eca-automs/MC-POL48MIAE-06/README.md

# MC-POL48MIAE-06
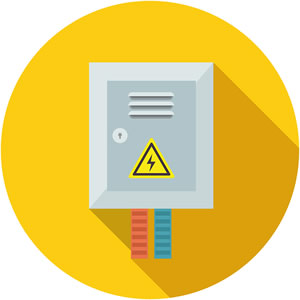
[picture p1: res/el_icon_4.jpg]
electric_panel_icon

## Schema per quadro elettrico per ascensore

### Scheda controllo
MCPX2015-SMD - PER16B-SMD

### Tipo impianto
Oleodinamico.

### Manovra
Prenotazione.

### Operatore porte
Automatico trifase, automatico elettronico.

### Avviamento / controllo motore
Diretto, stella-triangolo, soft-starter con SMS-Start.

### Potenza massima motore / taglie compatibili

#### Avviamento diretto
Taglia|Potenza
---|---
S40|14CV-230VAC/22CV-400VAC

#### Avviamento stella-triangolo
Taglia|Potenza
---|---
S70|24CV-230VAC/43CV-400VAC

#### Avviamento soft-starter
Taglia|Potenza
---|---
S60|17CV-230VAC/35CV-400VAC

### Allarme
12VDC, Legge 13.

### Emergenza
Totale con riapertura porte con inverter SMS MIAE.

### Emendamento A3
Nessuno.
