eca-automs/MC-POL48MIAE-06/dxf/7-MC-POL48MIAE-06.dxf

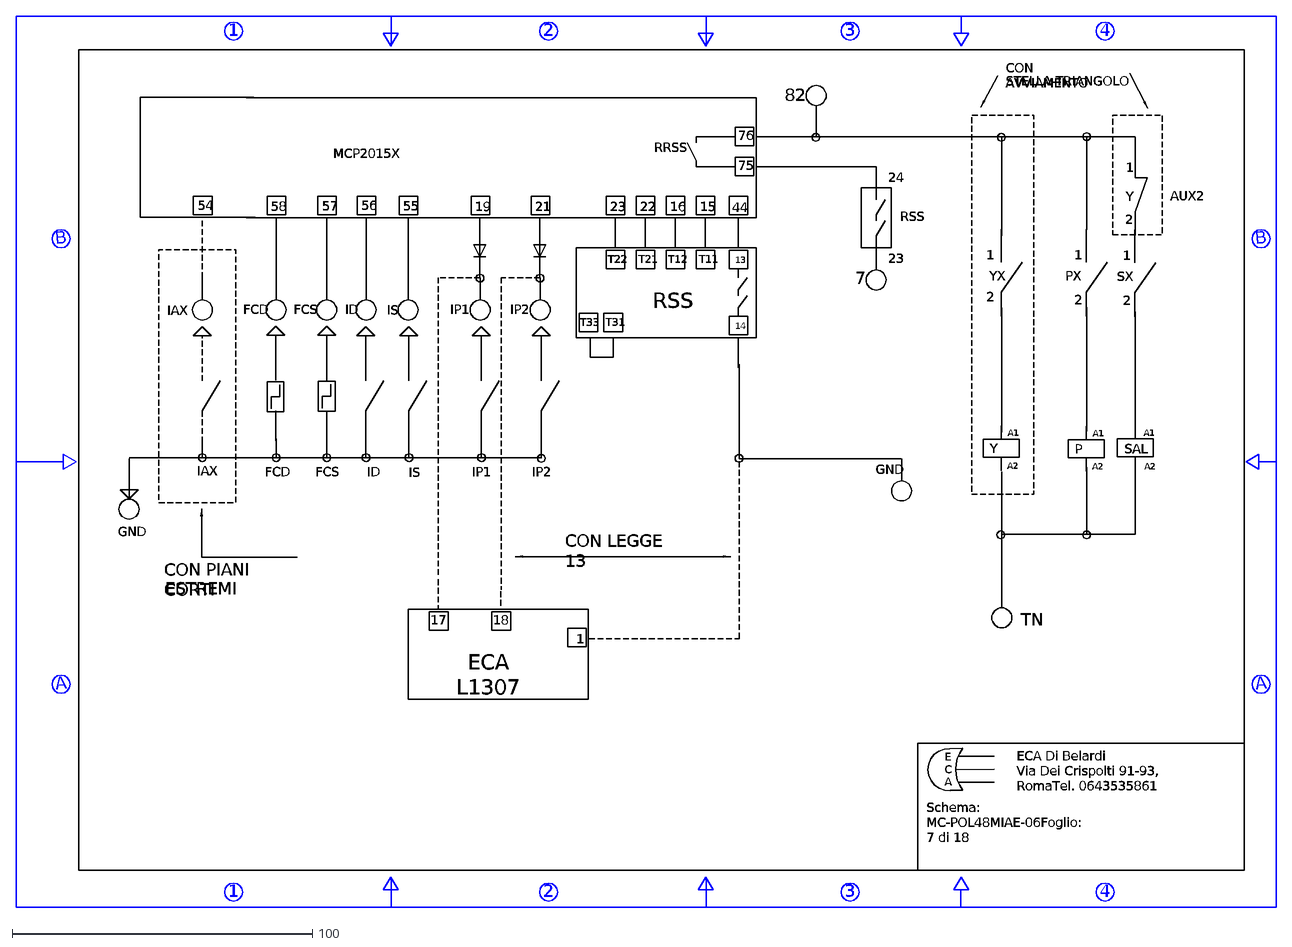
[picture p2: CAD file, 2018-07-23]
dxf/7-MC-POL48MIAE-06.dxf
A
B
1
2
3
4
E C A
ECA Di Belardi Via Dei Crispolti 91-93, Roma Tel. 0643535861
MCP2015X
58
T22
T21
T12
T11
23
22
16
15
13
14
44
FCD
76
75
RRSS
24
RSS
7
T31
19
21
IP1
IP2
57
FCS
ID
56
55
IS
17
ECA L1307
18
54
IAX
CON PIANI CORTI
ESTREMI
CON LEGGE 13
GND
A1
A2
SAL
YX
PX
SX
Y
P
TN
T33
STELLA-TRIANGOLO
CON AVVIAMENTO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
