eca-automs/MC-POL48MIAE-06/dxf/12-MC-POL48MIAE-06.dxf

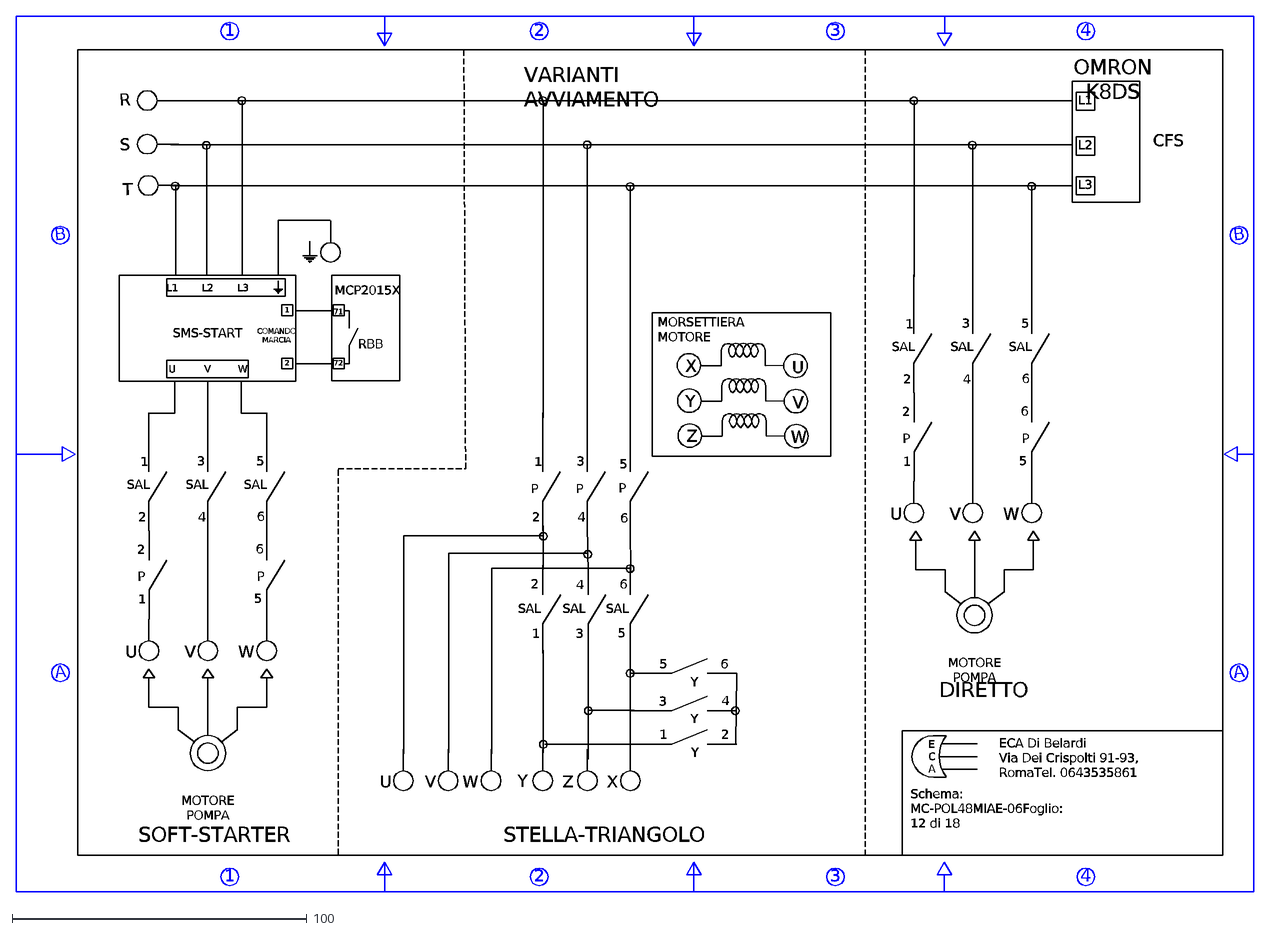
[picture p3: CAD file, 2018-07-23]
dxf/12-MC-POL48MIAE-06.dxf
A
B
1
2
3
4
E C A
ECA Di Belardi Via Dei Crispolti 91-93, Roma Tel. 0643535861
R
S
T
L2
L1
L3
OMRON K8DS
U
V
W
COMANDO MARCIA
71
72
SMS-START
MCP2015X
MOTORE POMPA
SAL
P
5
6
Y
X
Z
MORSETTIERA MOTORE
VARIANTI AVVIAMENTO
SOFT-STARTER
STELLA-TRIANGOLO
DIRETTO
RBB
CFS
Schema: MC-POL48MIAE-06 Foglio: 12 di 18
