eca-automs/MC-POL48MIAE-06/dxf/11-MC-POL48MIAE-06.dxf

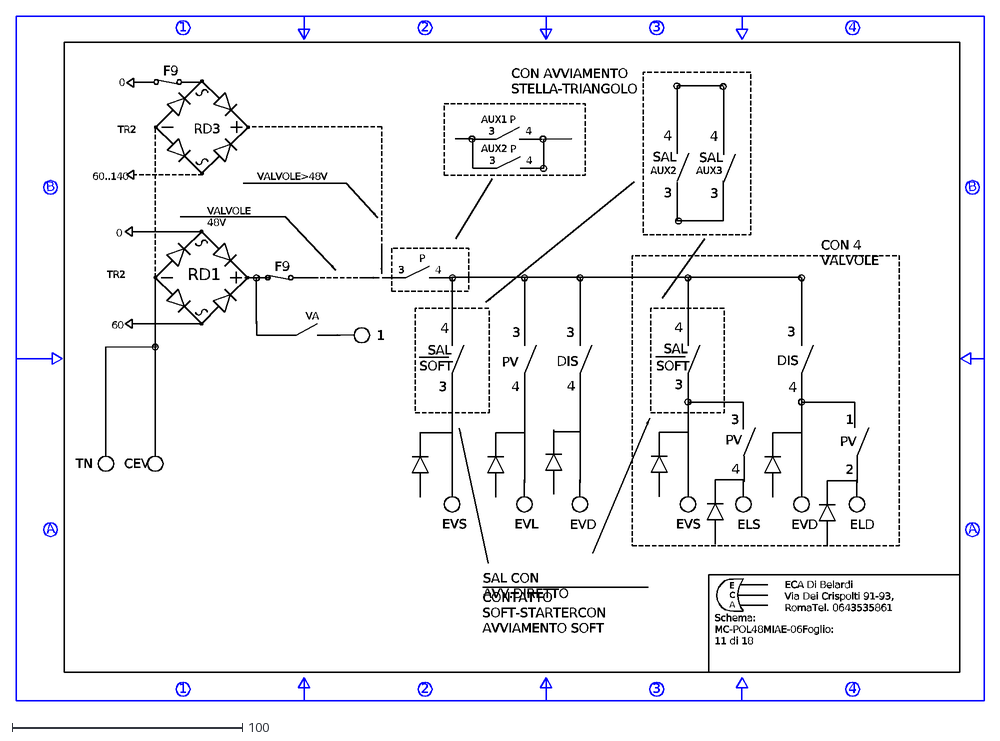
[picture p4: CAD file, 2018-07-23]
dxf/11-MC-POL48MIAE-06.dxf
A
B
1
2
3
4
E C A
ECA Di Belardi Via Dei Crispolti 91-93, Roma Tel. 0643535861
RD1
0
60
TR2
F9
P
VA
VALVOLE 48V
VALVOLE>48V
RD3
60..140
TN
CEV
EVL
ELS
ELD
DIS
EVS
EVD
PV
SAL
SOFT
CON 4 VALVOLE
SAL CON AVV.DIRETTO
CONTATTO SOFT-STARTER CON AVVIAMENTO SOFT
AUX1
AUX2
CON AVVIAMENTO STELLA-TRIANGOLO
Schema: MC-POL48MIAE-06 Foglio: 11 di 18
AUX3
