eca-automs/MC-POL48MIAE-06/dxf/2-MC-POL48MIAE-06.dxf

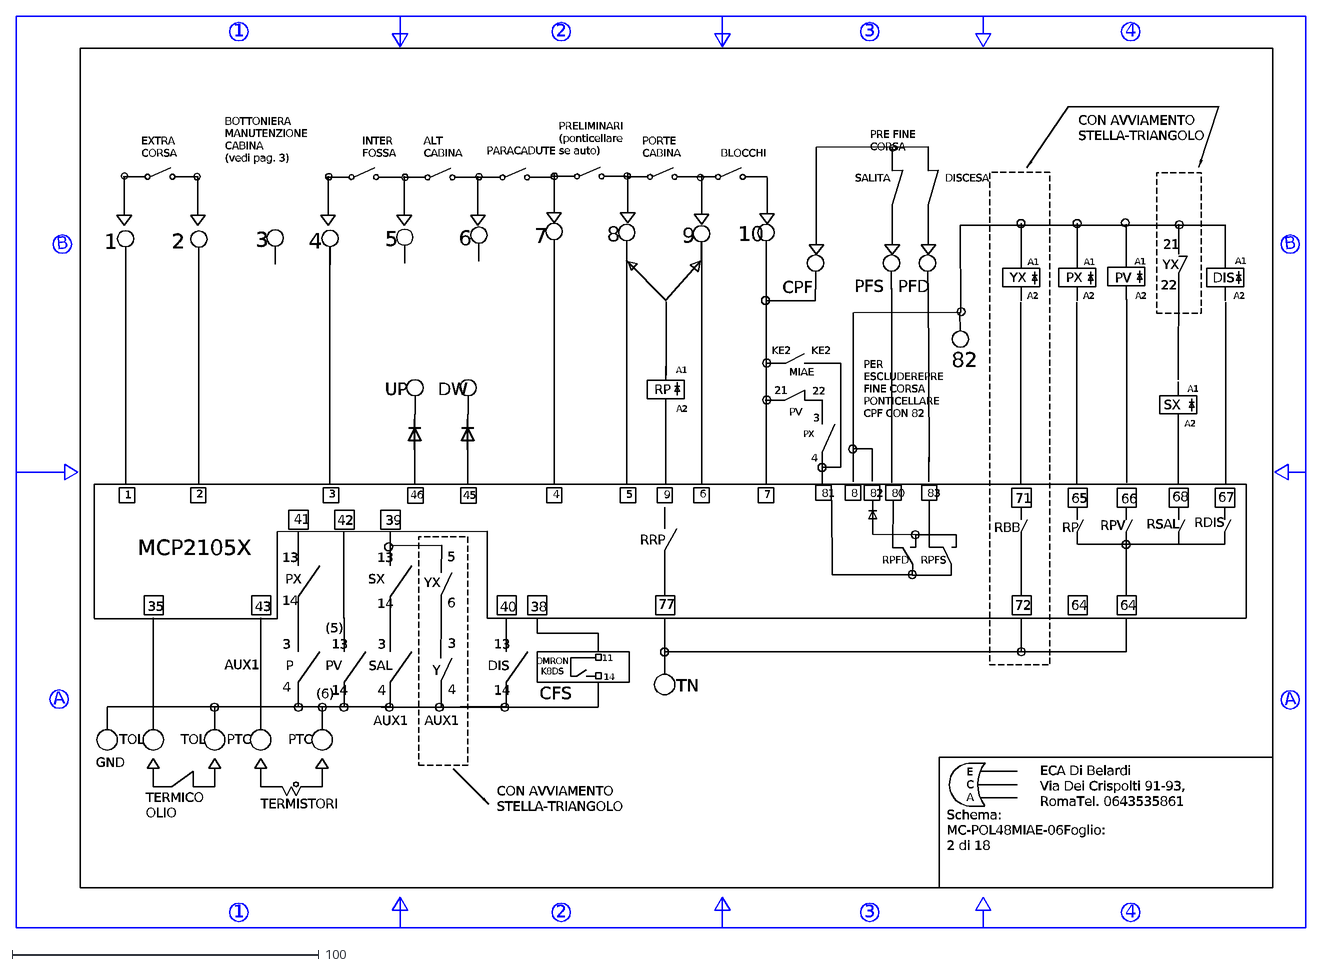
[picture p5: CAD file, 2018-07-23]
dxf/2-MC-POL48MIAE-06.dxf
E C A
ECA Di Belardi Via Dei Crispolti 91-93, Roma Tel. 0643535861
B
A
1
2
3
4
65
PV
DIS
64
RP
RPV
RSAL
RDIS
66
68
67
TOL
PTC
35
43
13
14
40
A1
A2
TERMICO OLIO
TERMISTORI
RBB
71
72
CON AVVIAMENTO STELLA-TRIANGOLO
5
6
9
7
8
EXTRA CORSA
INTER FOSSA
PRELIMINARI (ponticellare se auto)
ALT CABINA
PORTE CABINA
PARACADUTE
BLOCCHI
38
OMRON K8DS
11
CFS
RRP
77
TN
PRE FINE CORSA
SALITA
DISCESA
82
80
83
RPFD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
