eca-automs/MC-POL48MIAE-06/dxf/1-MC-POL48MIAE-06.dxf

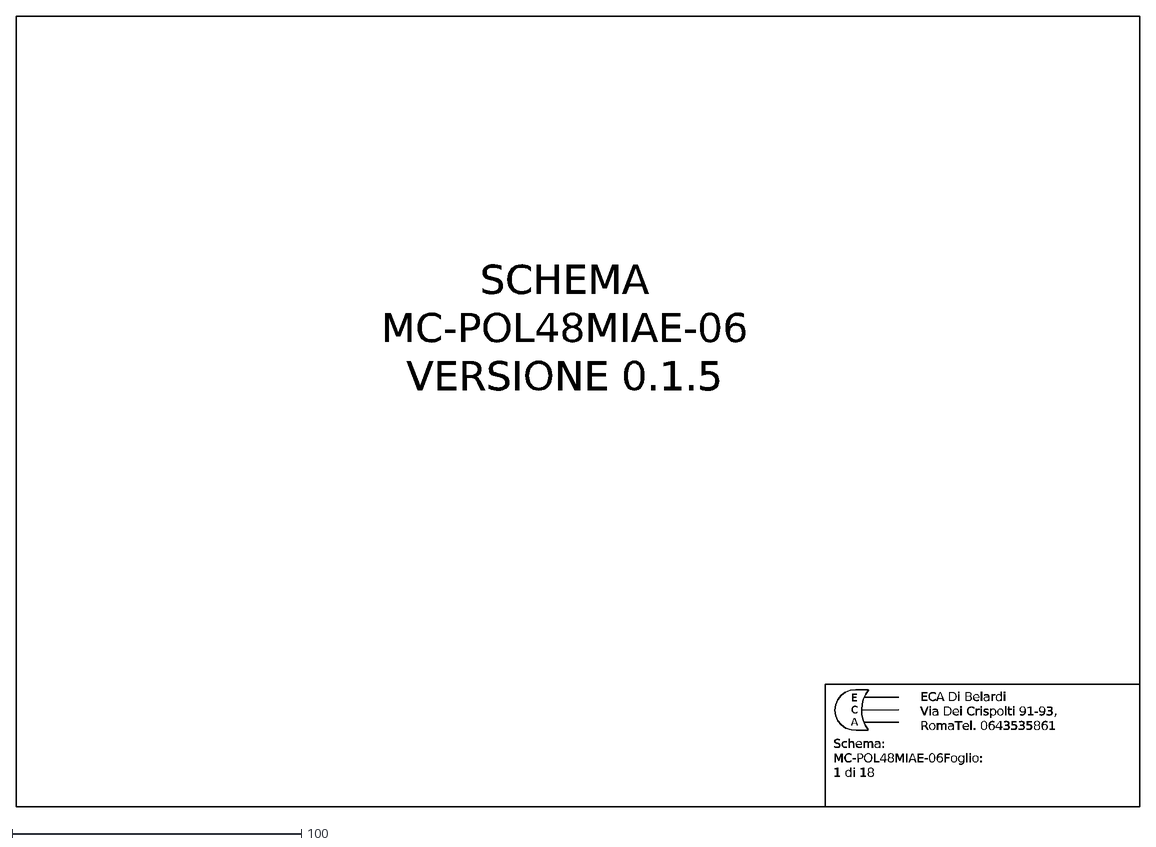
[picture p6: CAD file, 2018-07-23]
dxf/1-MC-POL48MIAE-06.dxf
E C A
ECA Di Belardi Via Dei Crispolti 91-93, Roma Tel. 0643535861
Schema: MC-POL48MIAE-06 Foglio: 1 di 18
SCHEMA MC-POL48MIAE-06 VERSIONE 0.1.5
