eca-automs/MC-POL48MIAE-06/dxf/10-MC-POL48MIAE-06.dxf

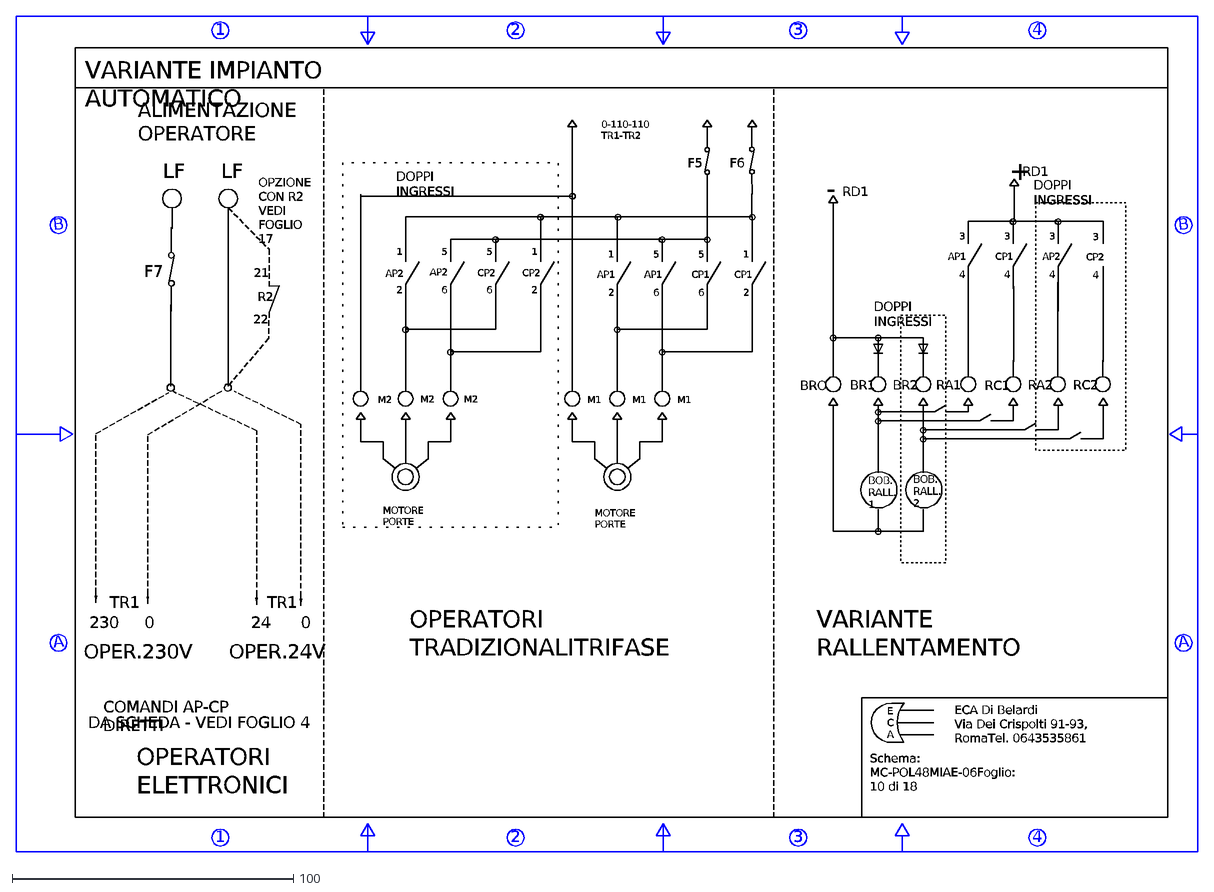
[picture p7: CAD file, 2018-05-28]
dxf/10-MC-POL48MIAE-06.dxf
A
B
1
2
3
4
E C A
ECA Di Belardi Via Dei Crispolti 91-93, Roma Tel. 0643535861
OPERATORI ELETTRONICI
230
0
24
TR1
LF
ALIMENTAZIONE OPERATORE
OPER.230V
OPER.24V
COMANDI AP-CP DIRETTI
VARIANTE IMPIANTO AUTOMATICO
F7
MOTORE PORTE
AP1
CP1
5
6
AP2
CP2
0-110-110 TR1-TR2
M1
M2
DOPPI INGRESSI
F5
F6
BRO
BR1
BR2
RA1
RC1
RA2
RC2
BOB. RALL. 1
BOB. RALL. 2
-
+
RD1
VARIANTE RALLENTAMENTO
OPERATORI TRADIZIONALI TRIFASE
DA SCHEDA - VEDI FOGLIO 4
R2
21
22
OPZIONE CON R2 VEDI FOGLIO 17
Schema: MC-POL48MIAE-06 Foglio: 10 di 18
