eca-automs/MC-POL48MIAE-06/dxf/18-MC-POL48MIAE-06.dxf

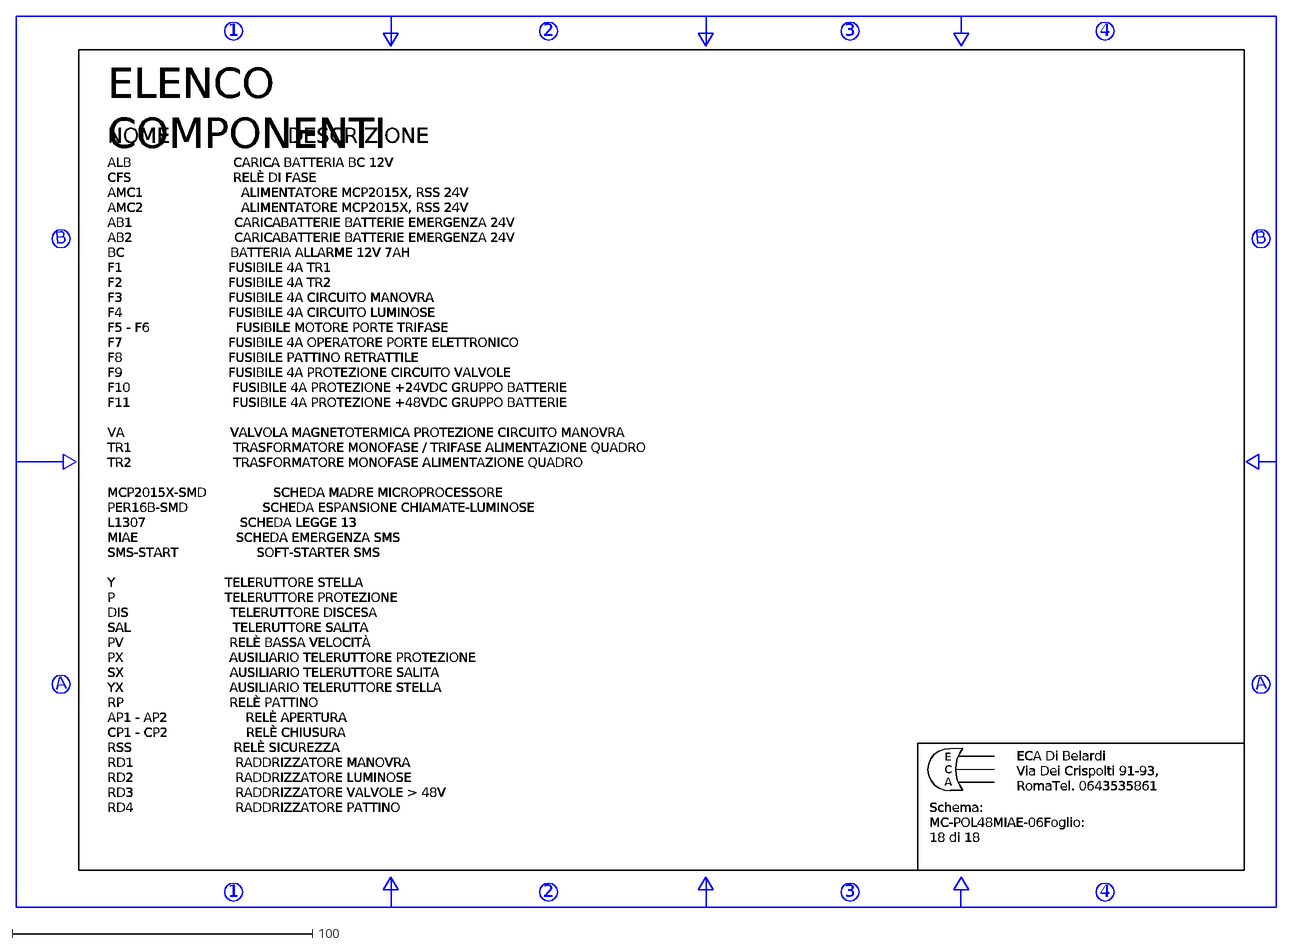
[picture p8: CAD file, 2018-05-28]
dxf/18-MC-POL48MIAE-06.dxf
A
B
1
2
3
4
E C A
ECA Di Belardi Via Dei Crispolti 91-93, Roma Tel. 0643535861
DESCRIZIONE
ELENCO COMPONENTI
NOME
ALB CARICA BATTERIA BC 12V CFS RELÈ DI FASE AMC1 ALIMENTATORE MCP2015X, RSS 24V AMC2 ALIMENTATORE MCP2015X, RSS 24V AB1 CARICABATTERIE BATTERIE EMERGENZA 24V AB
Schema: MC-POL48MIAE-06 Foglio: 18 di 18
