eca-automs/MC-POL48MIAE-06/dxf/8-MC-POL48MIAE-06.dxf

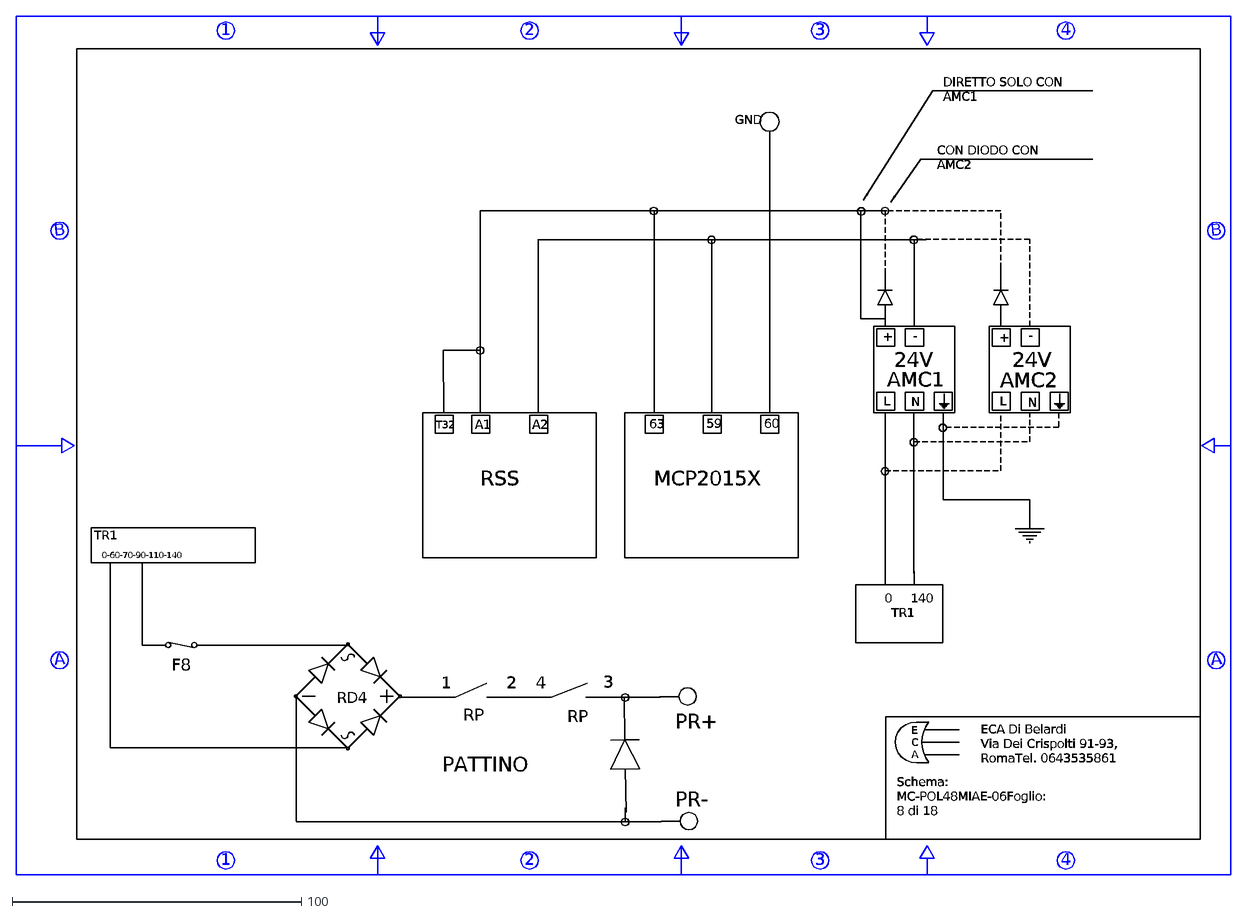
[picture p9: CAD file, 2018-05-28]
dxf/8-MC-POL48MIAE-06.dxf
A
B
1
2
3
4
E C A
MCP2015X
A1
A2
63
59
60
GND
+
-
L
N
ECA Di Belardi Via Dei Crispolti 91-93, Roma Tel. 0643535861
RSS
DIRETTO SOLO CON AMC1
CON DIODO CON AMC2
0
TR1
140
T32
24V
AMC2
AMC1
RP
PR+
PR-
PATTINO
F8
RD4
0-60-70-90-110-140
Schema: MC-POL48MIAE-06 Foglio: 8 di 18
