eca-automs/MC-POL48MIAE-06/dxf/3-MC-POL48MIAE-06.dxf

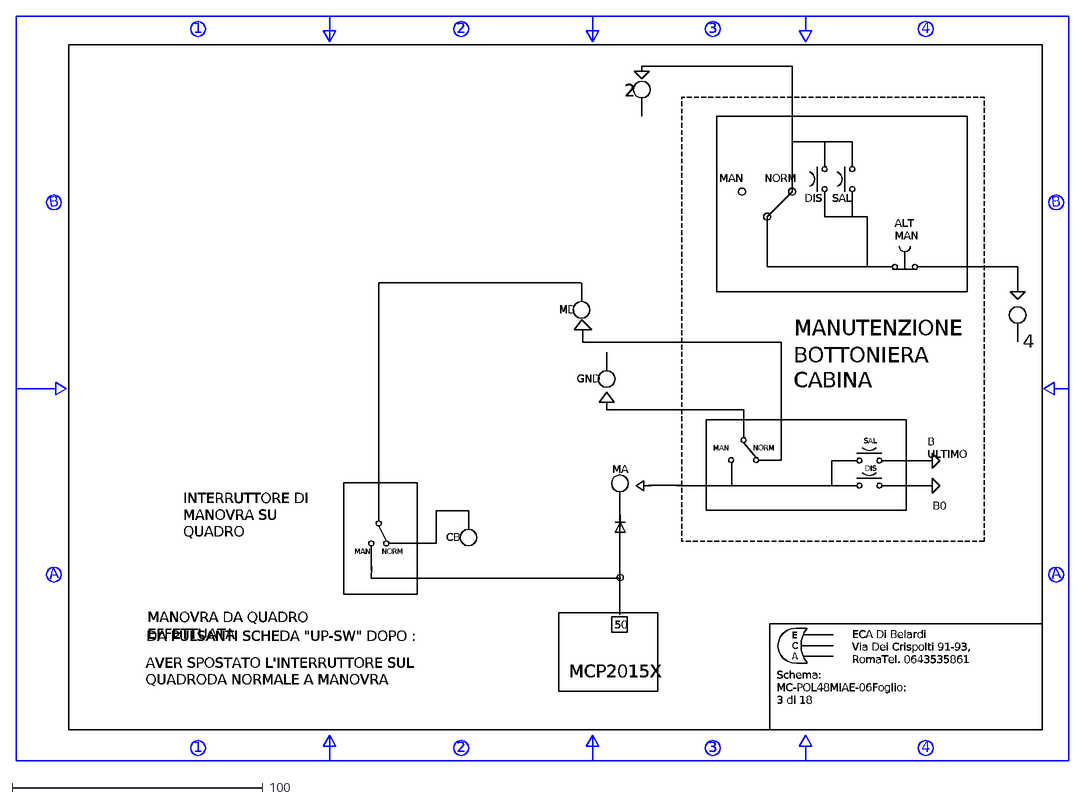
[picture p11: CAD file, 2018-05-28]
dxf/3-MC-POL48MIAE-06.dxf
A
B
1
2
3
4
E C A
ECA Di Belardi Via Dei Crispolti 91-93, Roma Tel. 0643535861
MAN
NORM
ALT MAN
DIS
SAL
MB
GND
MA
MCP2015X
50
MANOVRA DA QUADRO EFFETTUATA
DA PULSANTI SCHEDA "UP-SW" DOPO :
AVER SPOSTATO L'INTERRUTTORE SUL QUADRO DA NORMALE A MANOVRA
INTERRUTTORE DI MANOVRA SU QUADRO
BOTTONIERA CABINA
MANUTENZIONE
CB
B ULTIMO
B0
Schema: MC-POL48MIAE-06 Foglio: 3 di 18
