eca-automs/MC-POL48MIAE-06/dxf/13-MC-POL48MIAE-06.dxf

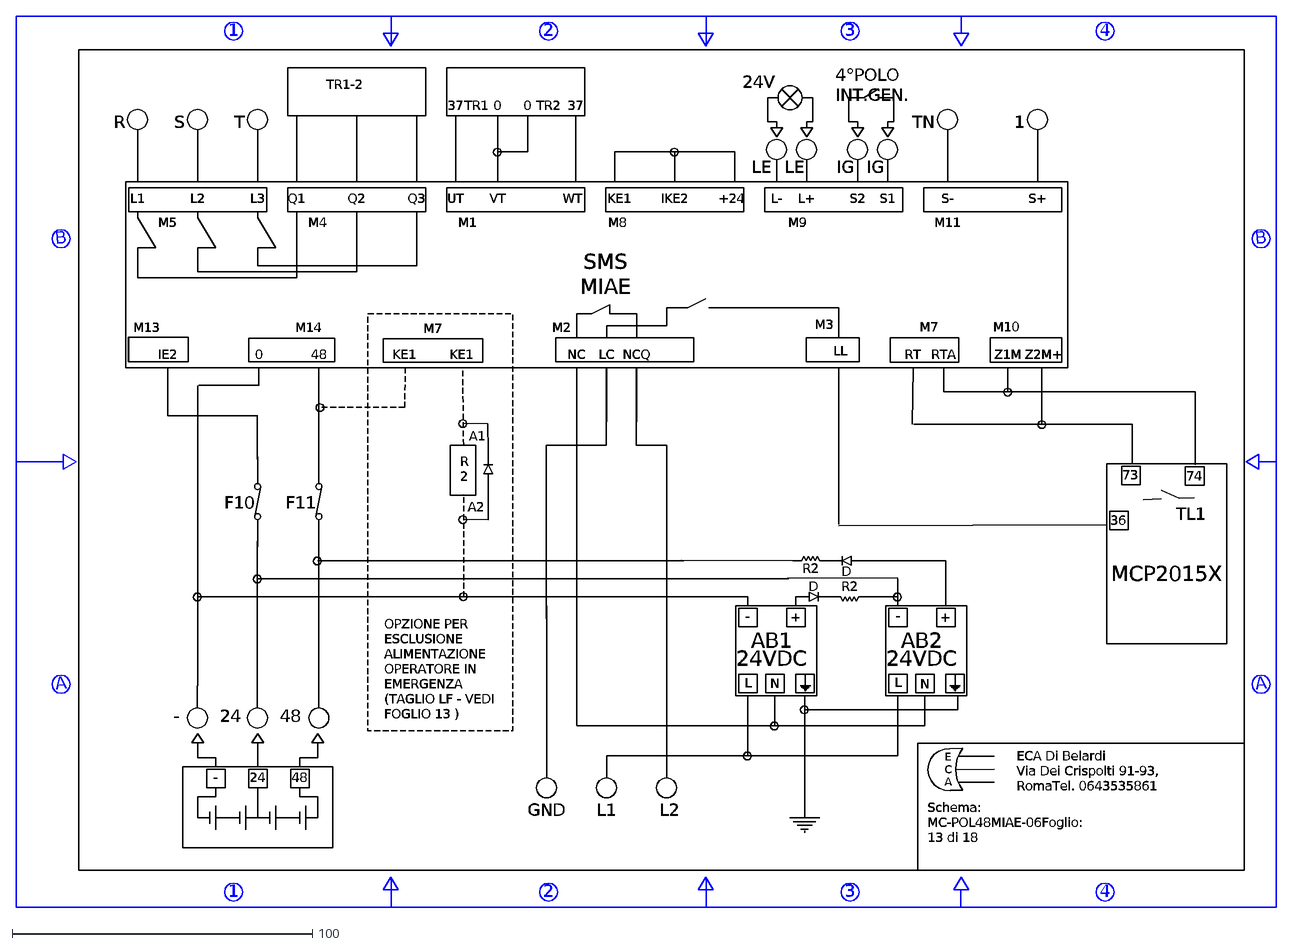
[picture p12: CAD file, 2018-05-28]
dxf/13-MC-POL48MIAE-06.dxf
A
B
1
2
3
4
E C A
M5
M4
M1
M8
M9
M11
M13
M14
L1
L2
L3
Q1
Q2
Q3
UT
VT
WT
37
0
TR1
TR2
TR1-2
IKE1
IKE2
+24
L-
L+
S2
S1
S-
S+
IE2
R
S
T
LE
IG
SMS MIAE
24
48
-
TN
ECA Di Belardi Via Dei Crispolti 91-93, Roma Tel. 0643535861
MCP2015X
36
73
74
24V
4°POLO INT.GEN.
F10
F11
TL1
Z2M+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
