eca-automs/MC-POL48MIAE-06/dxf/14-MC-POL48MIAE-06.dxf

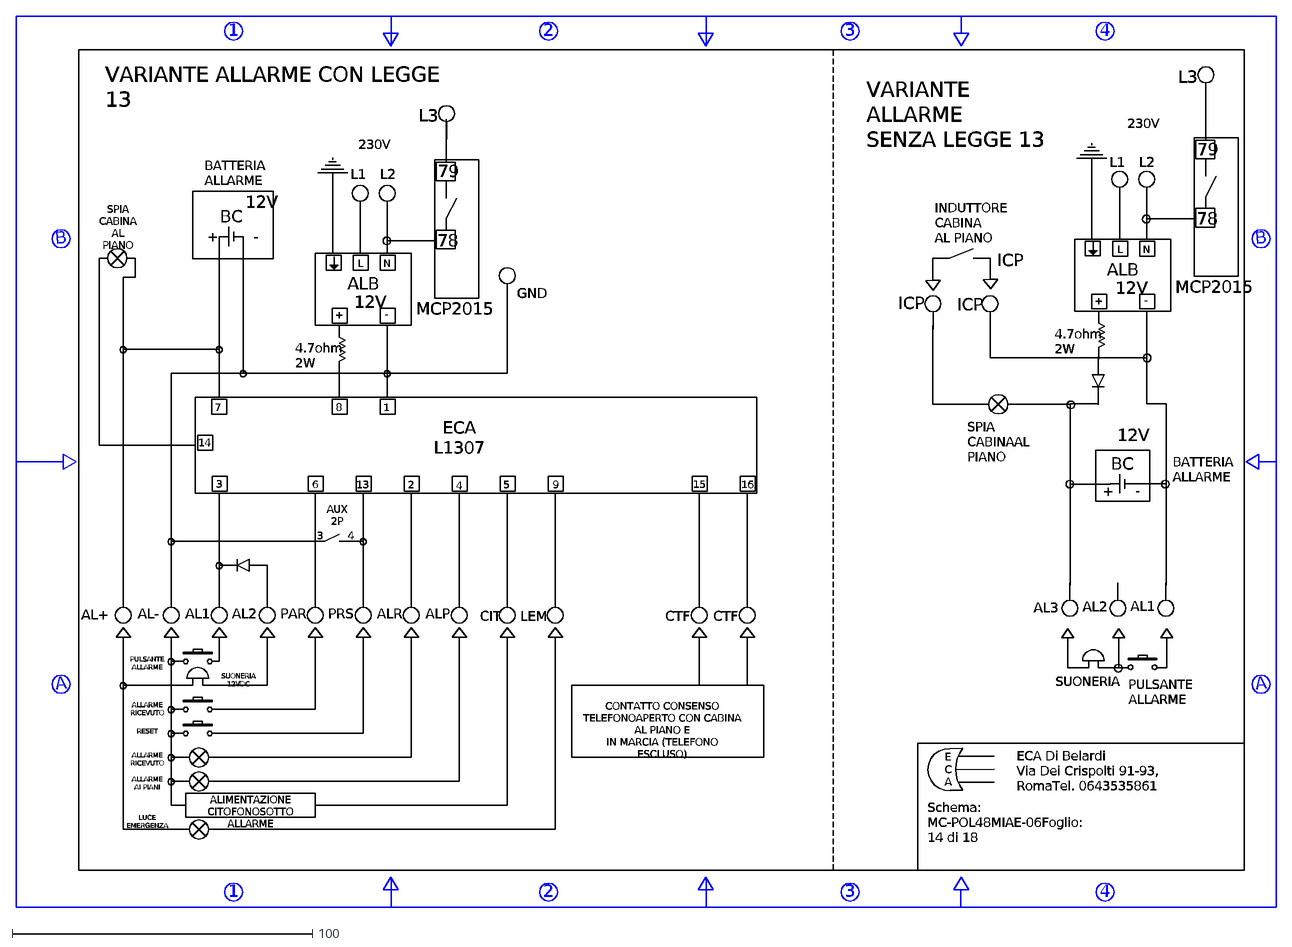
[picture p13: CAD file, 2018-05-28]
dxf/14-MC-POL48MIAE-06.dxf
A
B
1
2
3
4
E C A
ECA Di Belardi Via Dei Crispolti 91-93, Roma Tel. 0643535861
ALR
ALP
CIT
LEM
CTF
AL-
AL1
AL2
PAR
PRS
ALIMENTAZIONE CITOFONO SOTTO ALLARME
ECA L1307
ALB
PULSANTE ALLARME
SUONERIA 12VDC
ALLARME RICEVUTO
RESET
ALLARME AI PIANI
LUCE EMERGENZA
7
8
14
6
13
5
9
15
16
N
+
-
AUX 2 P
CONTATTO CONSENSO TELEFONO APERTO CON CABINA AL PIANO E IN MARCIA (TELEFONO ESCLUSO)
AL+
SPIA CABINA AL PIANO
BC
BATTERIA ALLARME
AL3
INDUTTORE CABINA AL PIANO
ICP
VARIANTE ALLARME SENZA LEGGE 13
12V
L3
79
78
MCP2015
GND
VARIANTE ALLARME CON LEGGE 13
SUONERIA
L
230V
L1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
