eca-automs/MC-POL48MIAE-06/dxf/17-MC-POL48MIAE-06.dxf

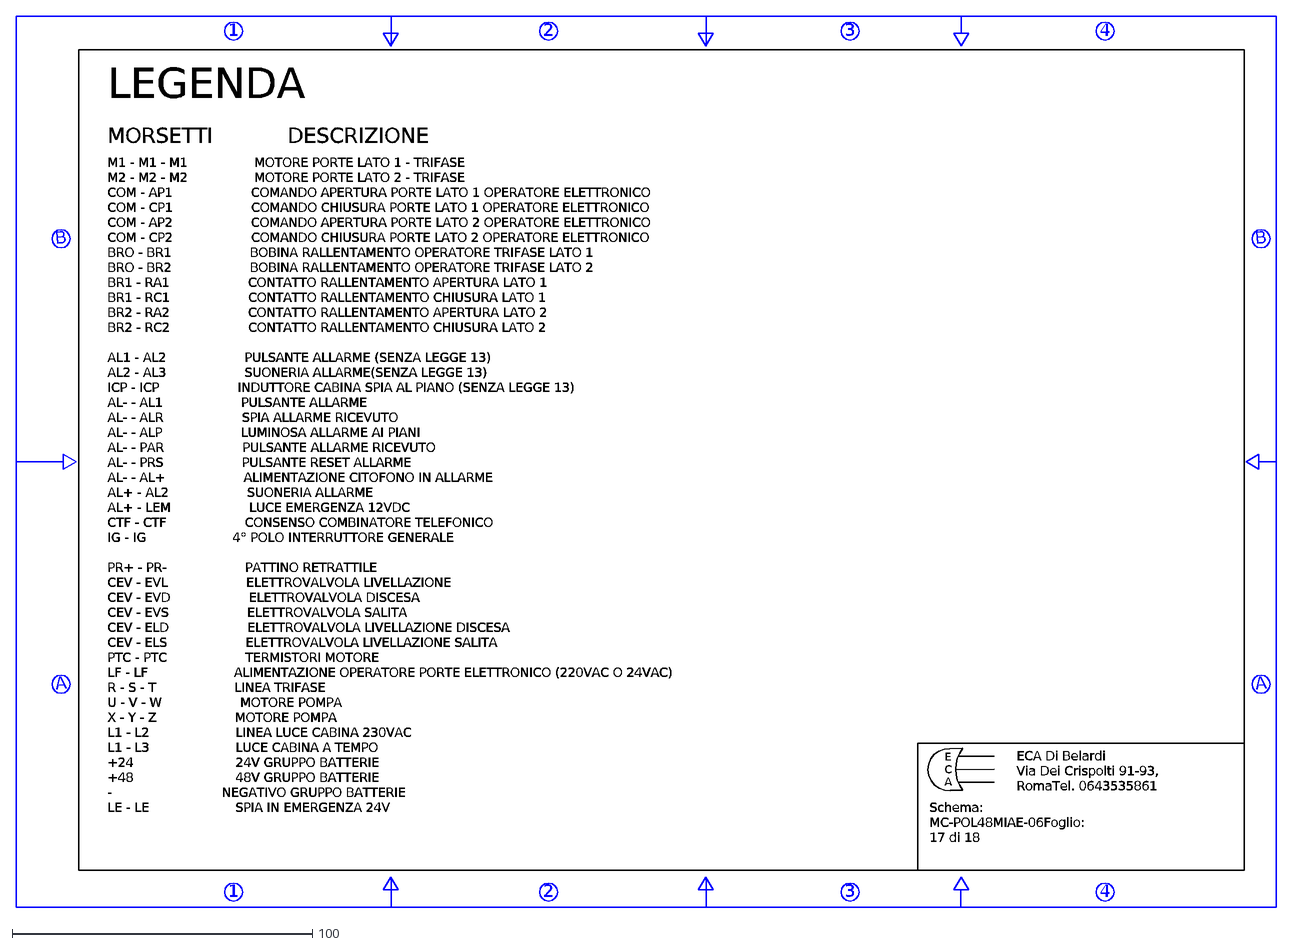
[picture p14: CAD file, 2018-05-28]
dxf/17-MC-POL48MIAE-06.dxf
A
B
1
2
3
4
E C A
ECA Di Belardi Via Dei Crispolti 91-93, Roma Tel. 0643535861
LEGENDA
MORSETTI
DESCRIZIONE
M1 - M1 - M1 MOTORE PORTE LATO 1 - TRIFASE M2 - M2 - M2 MOTORE PORTE LATO 2 - TRIFASE COM - AP1 COMANDO APERTURA PORTE LATO 1 OPERATORE ELETTRONICO COM - CP1 CO
Schema: MC-POL48MIAE-06 Foglio: 17 di 18
