eca-automs/MC-POL48MIAE-06/dxf/9-MC-POL48MIAE-06.dxf

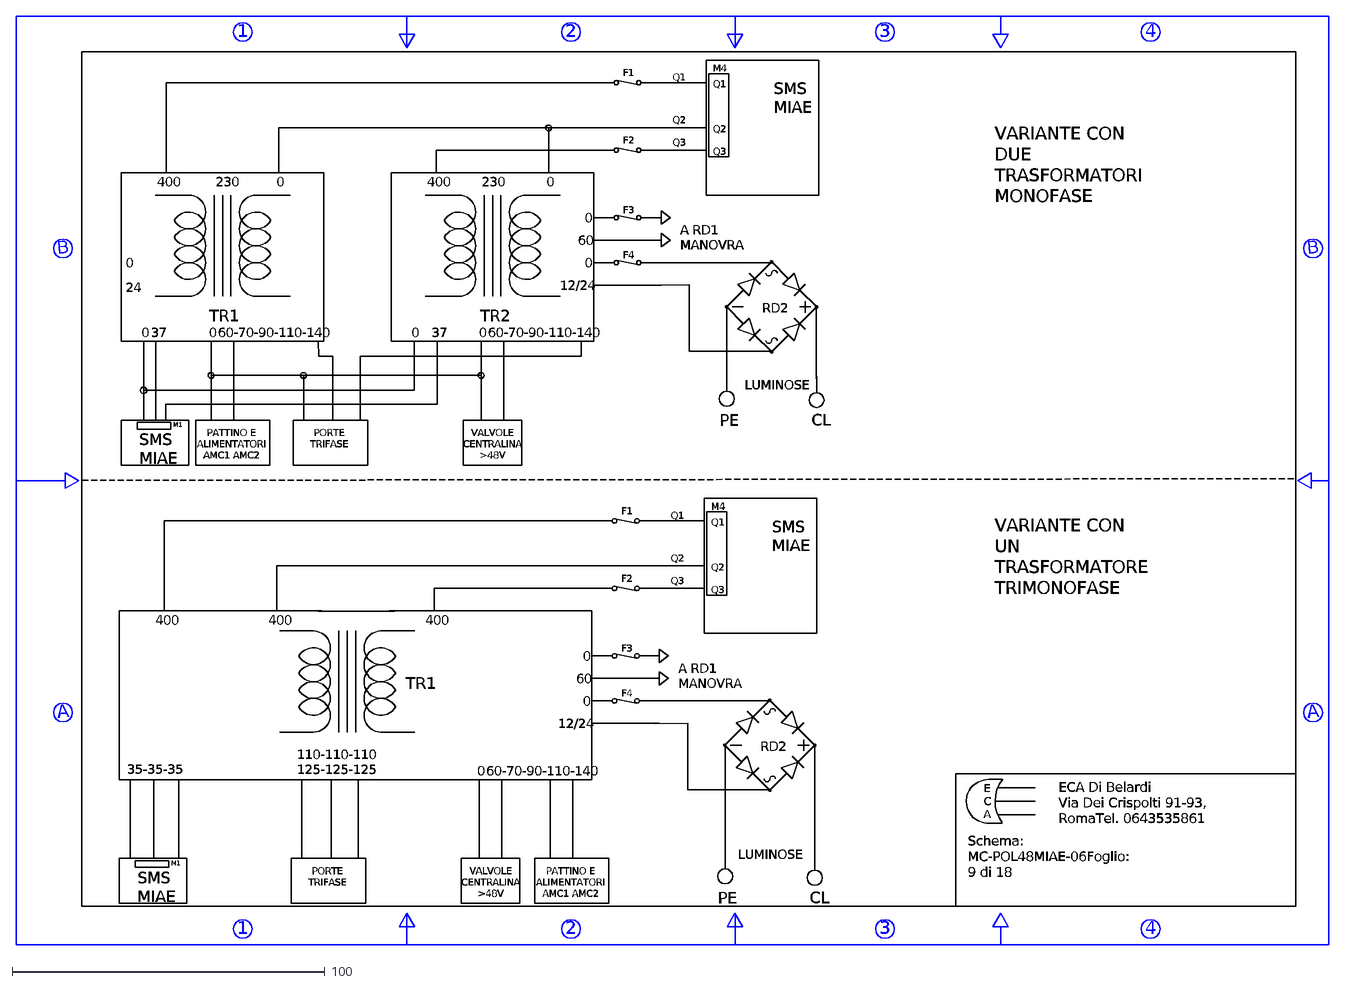
[picture p15: CAD file, 2018-05-28]
dxf/9-MC-POL48MIAE-06.dxf
A
B
1
2
3
4
E C A
ECA Di Belardi Via Dei Crispolti 91-93, Roma Tel. 0643535861
SMS MIAE
M1
M4
Q1
Q2
Q3
F1
F2
F3
F4
0
TR2
TR1
60-70-90-110-140
37
60
12/24
PATTINO E ALIMENTATORI AMC1 AMC2
24
VALVOLE CENTRALINA >48V
PORTE TRIFASE
400
230
RD2
A RD1 MANOVRA
PE
CL
LUMINOSE
35-35-35
110-110-110 125-125-125
VARIANTE CON DUE TRASFORMATORI MONOFASE
VARIANTE CON UN TRASFORMATORE TRIMONOFASE
Schema: MC-POL48MIAE-06 Foglio: 9 di 18
