eca-automs/MC-POL48MIAE-06/dxf/6-MC-POL48MIAE-06.dxf

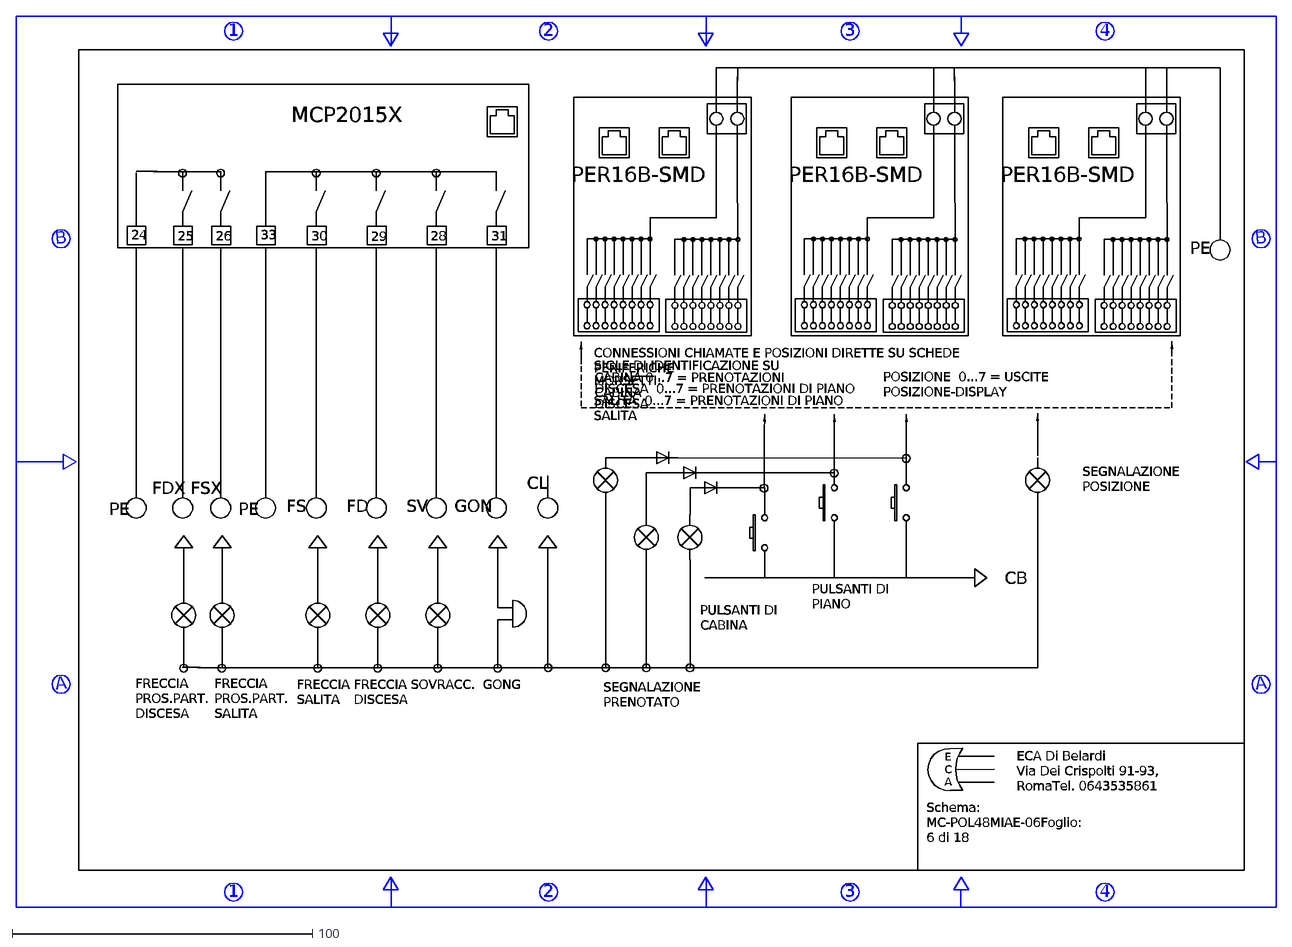
[picture p16: CAD file, 2018-05-28]
dxf/6-MC-POL48MIAE-06.dxf
A
B
1
2
3
4
E C A
ECA Di Belardi Via Dei Crispolti 91-93, Roma Tel. 0643535861
SEGNALAZIONE POSIZIONE
30
29
28
31
MCP2015X
GON
SV
FD
FS
33
PE
FRECCIA SALITA
FRECCIA DISCESA
SOVRACC.
GONG
25
26
FDX
FSX
24
FRECCIA PROS.PART. SALITA
FRECCIA PROS.PART. DISCESA
CL
CB
PULSANTI DI PIANO
PULSANTI DI CABINA
SEGNALAZIONE PRENOTATO
CONNESSIONI CHIAMATE E POSIZIONI DIRETTE SU SCHEDE PERIFERICHE
SIGLE DI IDENTIFICAZIONE SU MORSETTI:
CABINA 0...7 = PRENOTAZIONI CABINA
SALITA 0...7 = PRENOTAZIONI DI PIANO SALITA
DISCESA 0...7 = PRENOTAZIONI DI PIANO DISCESA
POSIZIONE 0...7 = USCITE POSIZIONE-DISPLAY
PER16B-SMD
Schema: MC-POL48MIAE-06 Foglio: 6 di 18
