eca-automs/MC-POL48MIAE-06/dxf/5-MC-POL48MIAE-06.dxf

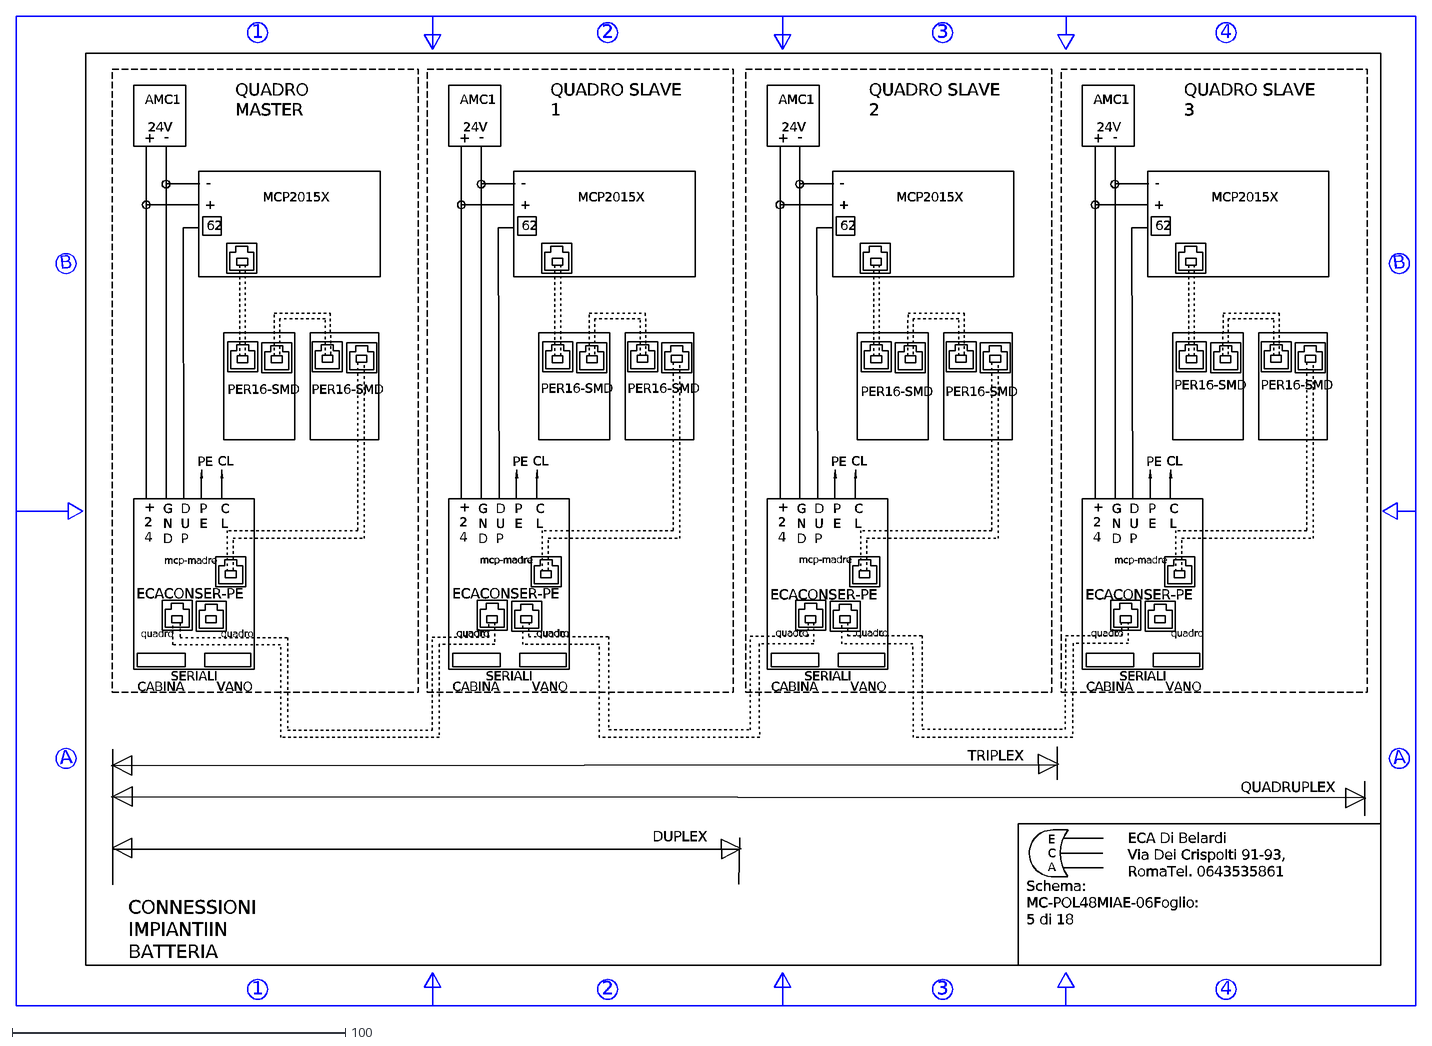
[picture p17: CAD file, 2018-05-28]
dxf/5-MC-POL48MIAE-06.dxf
A
B
1
2
3
4
E C A
ECA Di Belardi Via Dei Crispolti 91-93, Roma Tel. 0643535861
AMC1
+
-
24V
MCP2015X
CL
PE
+ 2 4
G N D
D U P
P E
C L
SERIALI
CABINA
VANO
QUADRO MASTER
ECACONSER-PE
QUADRO SLAVE 1
QUADRO SLAVE 2
QUADRO SLAVE 3
CONNESSIONI IMPIANTI IN BATTERIA
62
mcp-madre
quadro
DUPLEX
TRIPLEX
QUADRUPLEX
PER16-SMD
Schema: MC-POL48MIAE-06 Foglio: 5 di 18
