eca-automs/MC-POL48MIAE-06/dxf/4-MC-POL48MIAE-06.dxf

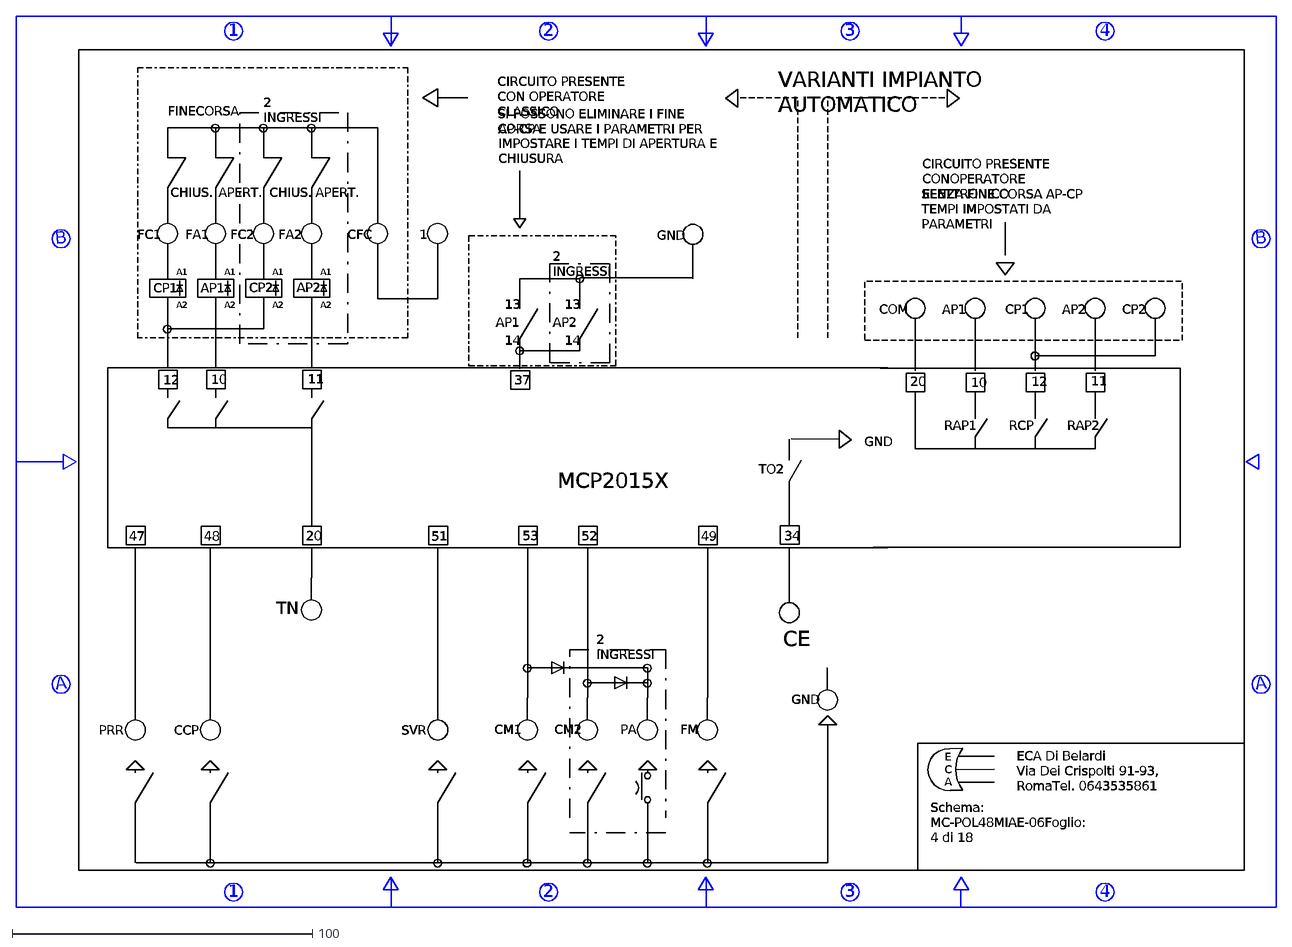
[picture p18: CAD file, 2018-05-28]
dxf/4-MC-POL48MIAE-06.dxf
A
B
1
2
3
4
E C A
12
10
11
FINECORSA
CHIUS.
APERT.
CP1
AP1
CP2
AP2
A2
A1
FC1
FA1
FA2
FC2
CFC
20
53
52
49
2 INGRESSI
GND
CM1
CM2
PA
FM
MCP2015X
TN
ECA Di Belardi Via Dei Crispolti 91-93, Roma Tel. 0643535861
51
SVR
37
13
14
CIRCUITO PRESENTE CON OPERATORE CLASSICO
COM
CIRCUITO PRESENTE CON OPERATORE ELETTRONICO
SENZA FINE CORSA AP-CP TEMPI IMPOSTATI DA PARAMETRI
SI POSSONO ELIMINARE I FINE CORSA
AP-CP E USARE I PARAMETRI PER
IMPOSTARE I TEMPI DI APERTURA E CHIUSURA
RAP1
RAP2
RCP
VARIANTI IMPIANTO AUTOMATICO
TO2
34
CE
PRR
CCP
47
48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
