eca-automs/MC-POL48MIAE-06/dxf/MORSETTI-ORIZ.dxf

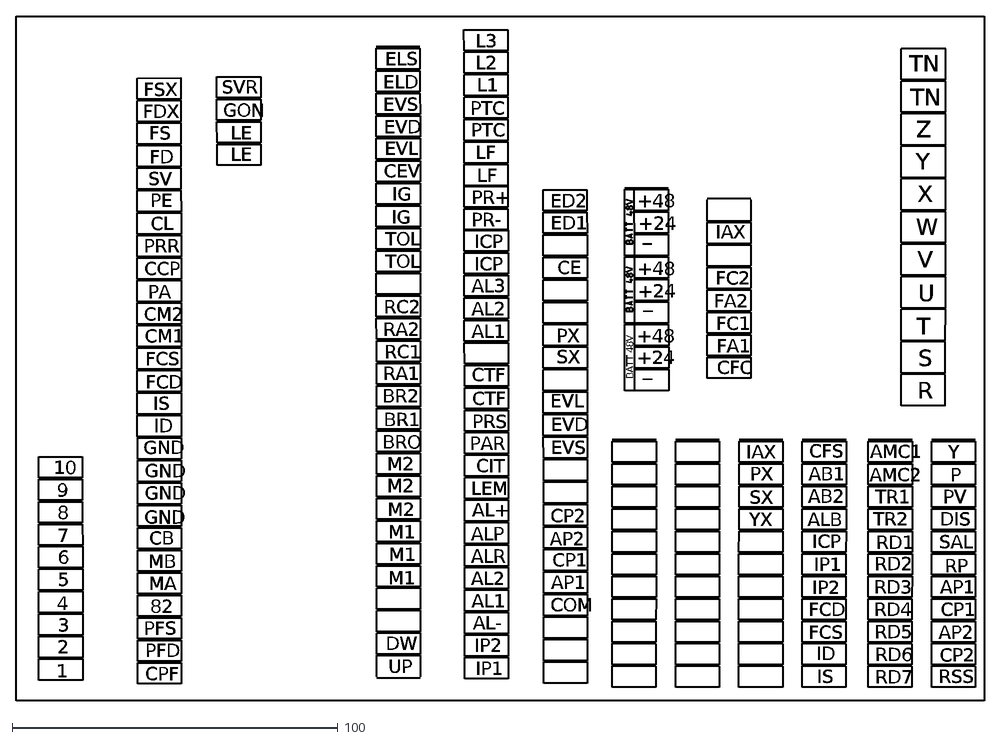
[picture p19: CAD file, 2017-06-01]
dxf/MORSETTI-ORIZ.dxf
Y
P
PV
DIS
SAL
RP
AP1
CP1
AP2
CP2
RSS
AMC1
AMC2
TR1
TR2
RD1
RD2
RD3
RD4
RD5
RD6
RD7
CFS
AB1
AB2
ALB
ICP
IP1
IP2
FCD
FCS
ID
IS
IAX
PX
SX
YX
BATT 48V
1
2
3
4
5
6
7
8
9
10
GND
CB
MB
MA
82
PFS
PFD
CPF
PE
CL
PRR
CCP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
