eca-automs/MC-POL48MIAE-06/dxf/15-MC-POL48MIAE-06.dxf

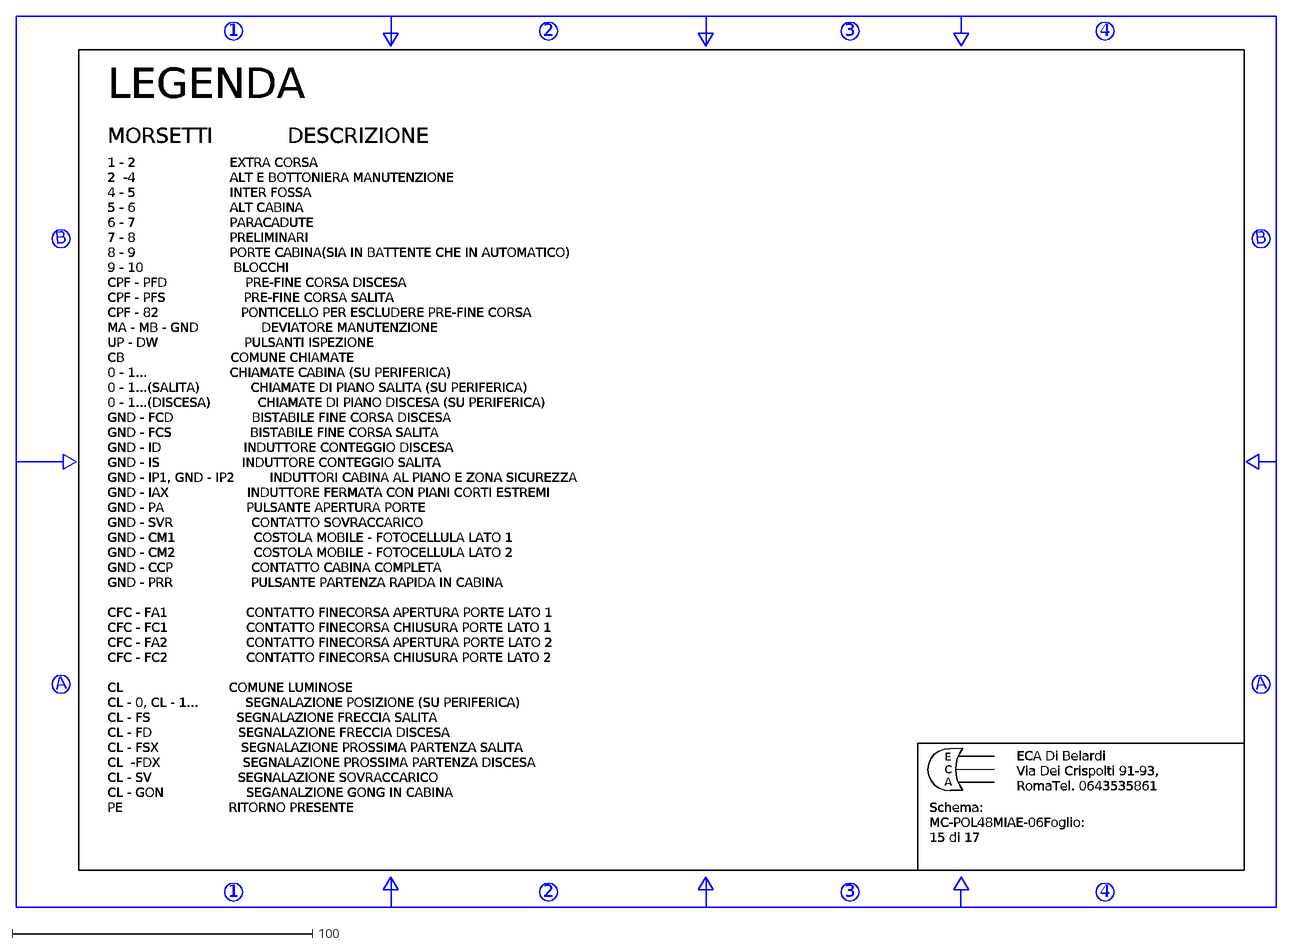
[picture p20: CAD file, 2017-04-15]
dxf/15-MC-POL48MIAE-06.dxf
A
B
1
2
3
4
E C A
ECA Di Belardi Via Dei Crispolti 91-93, Roma Tel. 0643535861
LEGENDA
MORSETTI
DESCRIZIONE
Schema: MC-POL48MIAE-06 Foglio: 15 di 17
1 - 2 EXTRA CORSA 2 -4 ALT E BOTTONIERA MANUTENZIONE 4 - 5 INTER FOSSA 5 - 6 ALT CABINA 6 - 7 PARACADUTE 7 - 8 PRELIMINARI 8 - 9 PORTE CABINA(SIA IN BATTENTE CH
