eca-automs/MC-POL48MIAE-06/dxf/MORSETTI.dxf

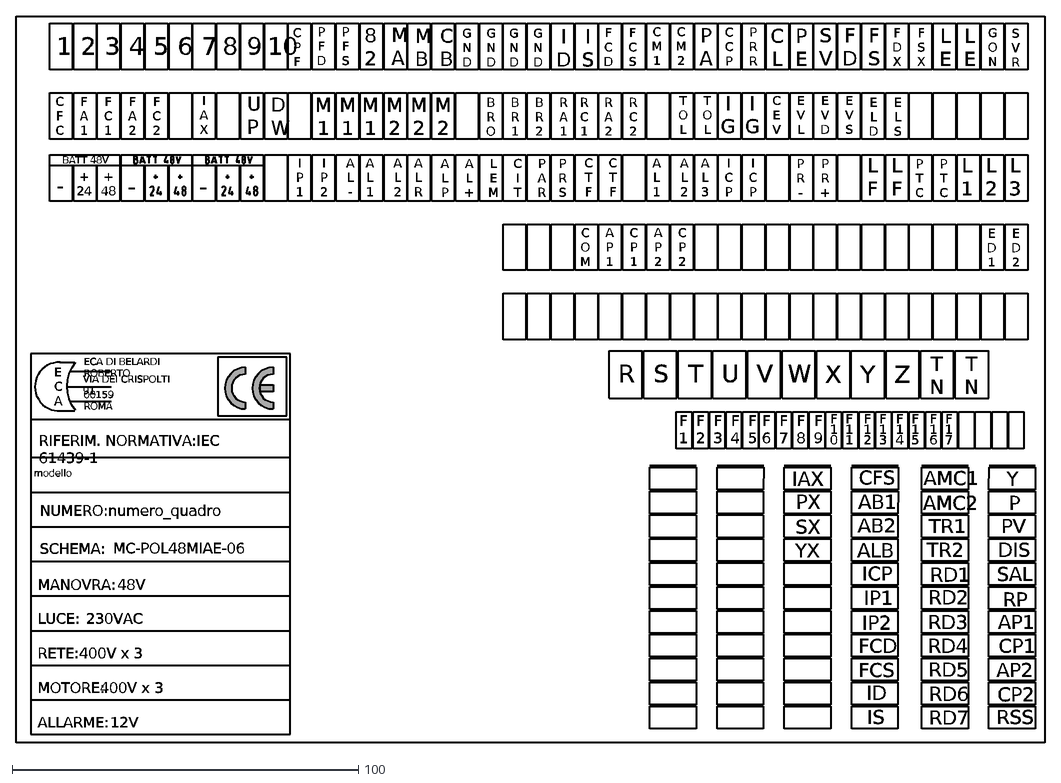
[picture p22: CAD file, 2016-12-22]
dxf/MORSETTI.dxf
1
2
3
4
5
6
7
9
10
8
T O L
C E V
E V L
I G
BATT 48V
-
+ 24
+ 48
R
S
T
U
V
W
X
Y
Z
T N
F 1
F 2
F 3
F 4
F 5
F 6
F 7
F 8
F 9
F 1 0
F 1 1
F 1 2
F 1 3
F 1 4
F 1 5
F 1 6
F 1 7
A L -
A L P
A L +
L E M
C I T
P A R
P R S
I P 1
I P 2
C T F
C F C
F A 1
F C 1
F A 2
F C 2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
