eca-automs/MC-POL48MIAE-06/CHANGELOG.md

## <small>0.1.5 (2018-07-23)</small>

* nuovo1 ([8d337c1](https://github.com/eca-automs/MC-POL48MIAE-06/commit/8d337c1))

## <small>0.1.4 (2018-05-29)</small>

* Sostituisce contatto 3-4 AUX di P con 3-4 di PX ([de68342](https://github.com/eca-automs/MC-POL48MIAE-06/commit/de68342))

## <small>0.1.3 (2018-05-28)</small>

* Add package scripts, remove unused files ([73b3284](https://github.com/eca-automs/MC-POL48MIAE-06/commit/73b3284))
* aggiunto foglio ([4c7e3d1](https://github.com/eca-automs/MC-POL48MIAE-06/commit/4c7e3d1))
* Bump version 0.1.3 ([2f68a04](https://github.com/eca-automs/MC-POL48MIAE-06/commit/2f68a04))

## 0.1.2 (2017-07-11)

* Aggiunto package.json file ([2a2ad1b](https://gitlab.com/eca-automs/schematics/MC-POL48MIAE-06/commit/2a2ad1b))
* Fix emergenza con prefinecorsa aperti ([ede9c2c](https://gitlab.com/eca-automs/schematics/MC-POL48MIAE-06/commit/ede9c2c))

## 0.1.1 (2017-06-07)

* added .gitlab dir ([9618e3a](https://gitlab.com/eca-automs/schematics/MC-POL48MIAE-06/commit/9618e3a))
* Build v0.1.0 ([8c2192b](https://gitlab.com/eca-automs/schematics/MC-POL48MIAE-06/commit/8c2192b))
* Fix prefinecorsa aperti e teleruttori marcia attratti ([27bfee8](https://gitlab.com/eca-automs/schematics/MC-POL48MIAE-06/commit/27bfee8))
* modifica morsettiera verticale ([dbb4bee](https://gitlab.com/eca-automs/schematics/MC-POL48MIAE-06/commit/dbb4bee))
* prefine corsa ([0c17c78](https://gitlab.com/eca-automs/schematics/MC-POL48MIAE-06/commit/0c17c78))
* Sistemato testo "modello" in morsettiera ([b3397de](https://gitlab.com/eca-automs/schematics/MC-POL48MIAE-06/commit/b3397de))
* trimonofase ([da8515d](https://gitlab.com/eca-automs/schematics/MC-POL48MIAE-06/commit/da8515d))

# 0.0.0 (2016-08-07)

* aggiunti boms ([1a44799](https://gitlab.com/eca-automs/schematics/MC-POL48MIAE-06/commit/1a44799))
* Create README.md ([c4a0a8b](https://gitlab.com/eca-automs/schematics/MC-POL48MIAE-06/commit/c4a0a8b))
* etichetta cabina al piano ([08f6f4f](https://gitlab.com/eca-automs/schematics/MC-POL48MIAE-06/commit/08f6f4f))
* First commit ([c123a87](https://gitlab.com/eca-automs/schematics/MC-POL48MIAE-06/commit/c123a87))
* fixed issue #4, issue #6, issue #7 ([36116d0](https://gitlab.com/eca-automs/schematics/MC-POL48MIAE-06/commit/36116d0)), closes [#4](https://gitlab.com/eca-automs/schematics/MC-POL48MIAE-06/issues/4) [#6](https://gitlab.com/eca-automs/schematics/MC-POL48MIAE-06/issues/6) [#7](https://gitlab.com/eca-automs/schematics/MC-POL48MIAE-06/issues/7)
* modificata etichetta quadro per predispozione riempimento automatico ([3e69496](https://gitlab.com/eca-automs/schematics/MC-POL48MIAE-06/commit/3e69496))
* modifiche relative a: issue #1, issue #2, issue #3, issue #5. aggiornata legenda ([b45d645](https://gitlab.com/eca-automs/schematics/MC-POL48MIAE-06/commit/b45d645))
* sostituito relè sicurezza vecchio con nuovo ([9dd160e](https://gitlab.com/eca-automs/schematics/MC-POL48MIAE-06/commit/9dd160e))
