eca-automs/MC-POL48MIAE-06/(commit log)

2016-07-07 sostituito relè sicurezza vecchio con nuovo
    [5-MC-POL48MIAE-06.dxf, 6-MC-POL48MIAE-06.dxf]
2016-07-20 modificata etichetta quadro per predispozione riempimento automatico
    [MORSETTI.dxf]
2016-07-27 modifiche relative a: issue #1, issue #2, issue #3, issue #5. aggiornata legenda
    [1-MC-POL48MIAE-06.dxf, 2-MC-POL48MIAE-06.dxf, 4-MC-POL48MIAE-06.dxf, Legenda.ods]
2016-07-28 etichetta cabina al piano
    [MORSETTI.dxf]
2016-08-07 fixed issue #4, issue #6, issue #7
    [10-MC-POL48MIAE-06.dxf, 11-MC-POL48MIAE-06.dxf, 12-MC-POL48MIAE-06.dxf, 13-MC-POL48MIAE-06.dxf, 14-MC-POL48MIAE-06.dxf, 2-MC-POL48MIAE-06.dxf, 3-MC-POL48MIAE-06.dxf, 4-MC-POL48MIAE-06.dxf]
2016-12-19 prefine corsa
    aggiunti prefinecprsa e correzioni varie
    [1-MC-POL48MIAE-06.dxf, 2-MC-POL48MIAE-06.dxf, 3-MC-POL48MIAE-06.dxf, 6-MC-POL48MIAE-06.dxf, ElencoComponenti.ods, Legenda.ods, MORSETTI.dxf]
2016-12-22 Sistemato testo "modello" in morsettiera
    [MORSETTI.dxf]
2017-03-29 trimonofase
    modifica fogli 2-7-8
    [2-MC-POL48MIAE-06.dxf, 7-MC-OL48MIAE-06.dxf, 8-MC-OL48MIAE-06.dxf]
2017-04-15 Build v0.1.0
    [1-MC-POL48MIAE-06.dxf, 10-MC-POL48MIAE-06.dxf, 11-MC-POL48MIAE-06.dxf, 12-MC-POL48MIAE-06.dxf, 13-MC-POL48MIAE-06.dxf, 15-MC-POL48MIAE-06.dxf, 16-MC-POL48MIAE-06.dxf, 17-MC-POL48MIAE-06.dxf]
2017-06-01 modifica morsettiera verticale
    aggiunta di morsetti su morsettiera verticale
    [MORSETTI-ORIZ.dxf]
2017-06-07 Fix prefinecorsa aperti e teleruttori marcia attratti Aggiunto contatto NO AUX3 su teleruttore P in serie a circuito su connettore 81 scheda MCP2015X-SMD per evitare che i teleruttori di marcia si at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
    [1-MC-POL48MIAE-06.dxf, 2-MC-POL48MIAE-06.dxf]
2017-07-11 Fix emergenza con prefinecorsa aperti
    Aggiunto contatto della MIAE di bypass dei prefinecorsa. Senza questa modifica in
    emergenza, se i prefinecorsa sono aperti, l'impianto non parte.
    [2-MC-POL48MIAE-06.dxf]
2017-07-11 Bump version 0.1.2
    [1-MC-POL48MIAE-06.dxf]
2018-05-28 aggiunto foglio
    [10-MC-POL48MIAE-06.dxf, 11-MC-POL48MIAE-06.dxf, 13-MC-POL48MIAE-06.dxf, 14-MC-POL48MIAE-06.dxf, 15-MC-POL48MIAE-06.dxf, 16-MC-POL48MIAE-06.dxf, 17-MC-POL48MIAE-06.dxf, 18-MC-POL48MIAE-06.dxf]
2018-05-28 Bump version 0.1.3
    [1-MC-POL48MIAE-06.dxf]
2018-05-29 Sostituisce contatto 3-4 AUX di P con 3-4 di PX
    [1-MC-POL48MIAE-06.dxf, 2-MC-POL48MIAE-06.dxf]
2018-07-23 nuovo1
    -corregge contatto yx foglio1 da 1-2 a 21-22
    -corregge contatto sal 4-3 e morsetti y-z-x stella-triangolo
    -definisce numero contatti aux teleruttori
    [1-MC-POL48MIAE-06.dxf, 11-MC-POL48MIAE-06.dxf, 12-MC-POL48MIAE-06.dxf, 2-MC-POL48MIAE-06.dxf, 7-MC-POL48MIAE-06.dxf]
